kanengomibako/NusoraPlus/README.md

# Nusora+
### Nutube OverDrive Pedal
KORG社の真空管Nutubeを搭載した、真空管らしいスタンダードな歪みが得られるオーバードライブです。

### 各部の機能
- INPUT 端子：ギターや他の機器からの出力を接続します。

- OUTPUT 端子：アンプや他の機器の入力へ接続します。

- +9VDC 端子：ACアダプターを接続します。

  ACアダプターは、DC9V（センターマイナス）出力で、0.1A以上の電流出力が可能なものを使用してください。

- フットスイッチ：エフェクトオン／オフを切り替えます。

- Vol：出力音量を調節します。

- Gain：歪み具合を調節します。

- Tone：音色を調節します。時計回りに回すと、低音域をカットし高音域がブーストされます。

- Comp：ピッキング時の歪みの質感が変化します。繊細なコントロールなため、変化を感じにくい場合があります。

**※ GainとCompは連動しているため、Gainを上げた際はCompは最小付近で変化します。また、Compを上げた際に低音域が増強される現象が起きることがありますが、正常動作となります。**

### 資料
- [Nusora+ 製作に関する記事](https://kanengomibako.github.io/pages/00314.html)

- [Nusora 製作に関する記事](https://kanengomibako.github.io/pages/00304.html)

| 主な仕様 |  |
| - | - |
| 入力インピーダンス | 690kΩ |
| 出力インピーダンス | 1 kΩ |
| バイパス | トゥルー・バイパス |
| コントロール | バイパススイッチ　Volつまみ　Gainつまみ　Toneつまみ　Compつまみ |
| インジケーター | 橙色LED（直径3mm） |
| 接続端子 | INPUT端子　OUTPUT端子　電源入力端子 |
| 消費電流 | 40 mA |
| 外形寸法 | 幅 66 mm × 奥行 100 mm × 高さ 51 mm<br/>（つまみ、スイッチ部を除いた高さ 31 mm） |
| 質量 | 約182 g |
