kanengomibako/NusoraPlus/Nusora_plus_schematic.png

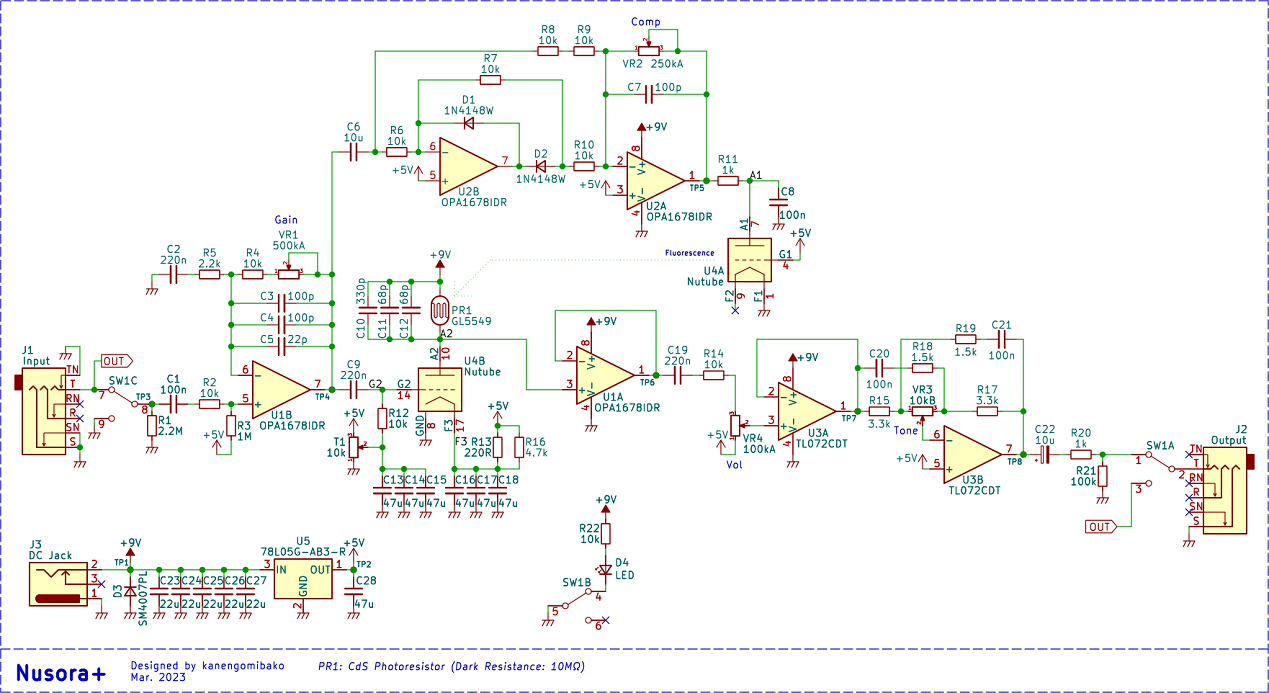
Nusora_plus_schematic.png
