kanengomibako/NusoraPlus/KiCad7/Main/nusora+.kicad_sch

## KiCad design KiCad7/Main/nusora+.kicad_sch (2023-03-23)

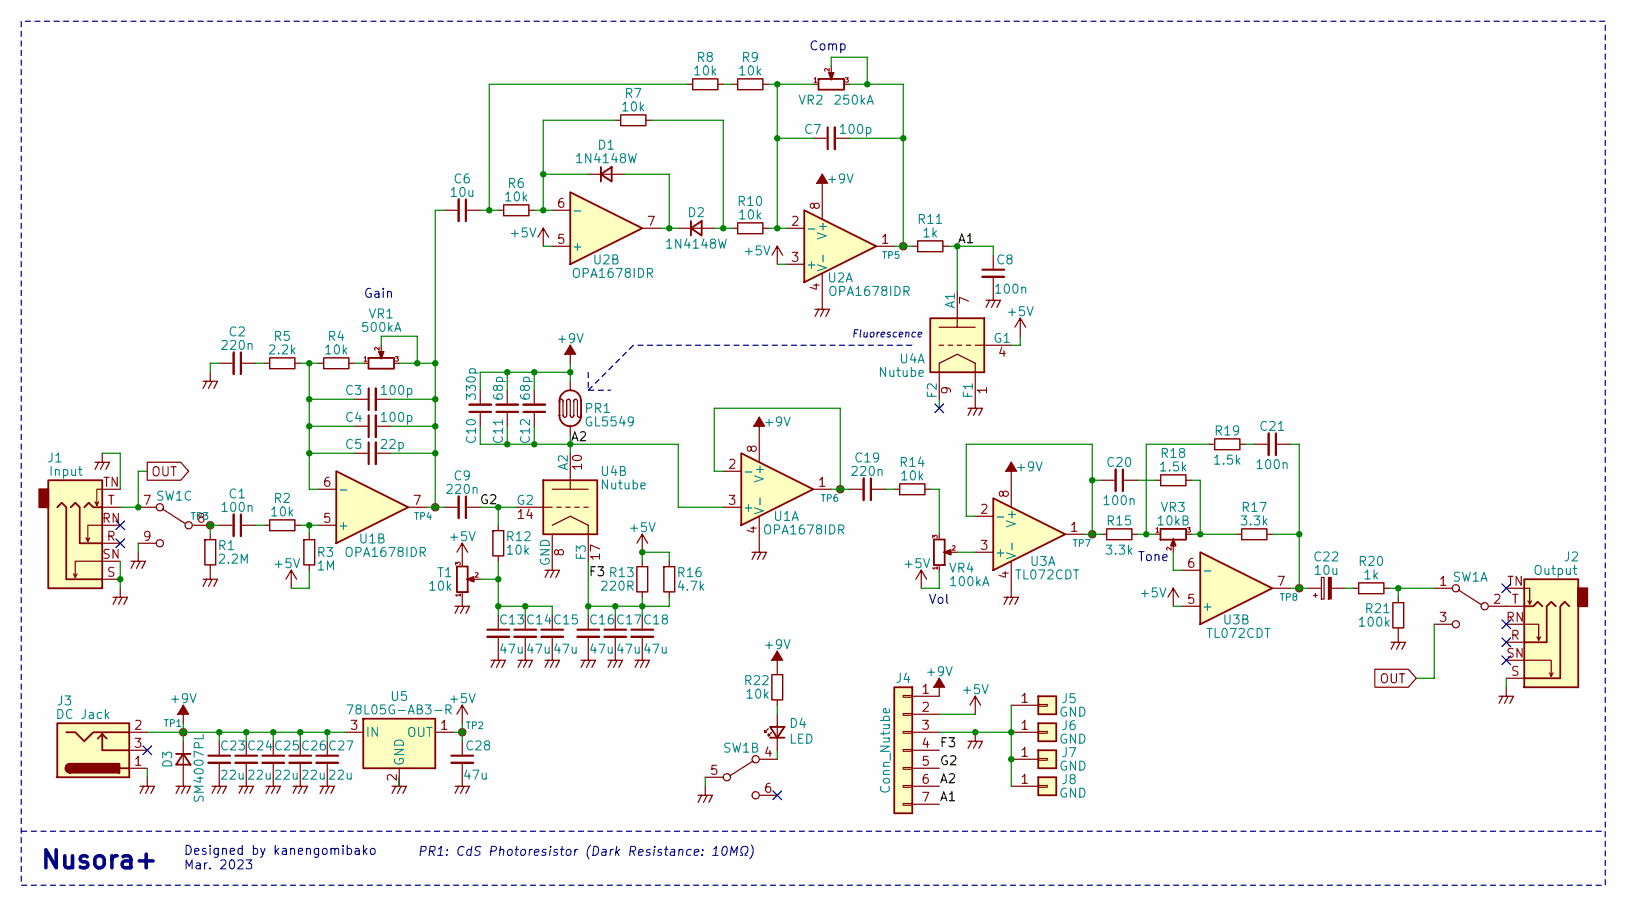
[picture p2: schematic nusora+.kicad_sch]

Parts:
C1, C8, C20, C21: 100n; C_1206_3216Metric
C2, C9, C19: 220n; C_1206_3216Metric
C3, C4, C7: 100p; C_0603_1608Metric
C5: 22p; C_0603_1608Metric
C6: 10u; C_1206_3216Metric
C10: 330p; C_0603_1608Metric
C11, C12: 68p; C_0603_1608Metric
C13, C14, C15, C16, C17, C18, C28: 47u; C_1206_3216Metric
C22: 10u; CP_EIA-3216-18_Kemet-A
C23, C24, C25, C26, C27: 22u; C_0805_2012Metric
D1, D2: 1N4148W; D_SOD-123
D3: SM4007PL; D_SOD-123F
D4: LED; my_LED_3mm
J1: Input; my_Phone_Jack_Daier
J2: Output; my_Phone_Jack_Daier
J3: DC Jack; my_DC_Jack
J4: Conn_Nutube; PinHeader_1x07_P2.54mm_Vertical
J5, J6, J7, J8: GND; PinHeader_1x01_P2.54mm_Vertical
PR1: GL5549; my_C_NP_P2.50mm
R1: 2.2M; R_0603_1608Metric
R2, R4, R6, R7, R8, R9, R10, R12, R14, R22: 10k; R_0603_1608Metric
R3: 1M; R_0603_1608Metric
R5: 2.2k; R_0603_1608Metric
R11, R20: 1k; R_0805_2012Metric
R13: 220R; R_0805_2012Metric
R15, R17: 3.3k; R_0603_1608Metric
R16: 4.7k; R_0603_1608Metric
R18, R19: 1.5k; R_0603_1608Metric
R21: 100k; R_0603_1608Metric
SW1: SW_3PDT; my_sw_3pdt_fujisoku
T1: 10k; my_trim2
TP1: +9V; my_SmallestPad_0-6mmDrill
TP2: +5V; my_SmallestPad_0-6mmDrill
TP3: FX_IN; my_SmallestPad_0-6mmDrill
TP4: U1B_OUT; my_SmallestPad_0-6mmDrill
TP5: U2B_OUT; my_SmallestPad_0-6mmDrill
TP6: U1A_OUT; my_SmallestPad_0-6mmDrill
TP7: U3A_OUT; my_SmallestPad_0-6mmDrill
TP8: U3B_OUT; my_SmallestPad_0-6mmDrill
U1, U2: OPA1678IDR; SOIC-8_3.9x4.9mm_P1.27mm_rotate
U3: TL072CDT; SOIC-8_3.9x4.9mm_P1.27mm_rotate
U4: Nutube; Nutube_small
U5: 78L05G-AB3-R; SOT-89-3-rotate
VR1: 500kA; my_pot123
VR2: 250kA; my_pot123
VR3: 10kB; my_pot123
VR4: 100kA; my_pot123

Connections:
+5V: C28.1, J4.2, R3.2, R13.1, R16.1, T1.3, TP2.1, U2.3 (+), U2.5 (+), U3.5 (+), U4.4 (G1), U5.1 (OUT), VR4.1
+9V: C10.2, C11.2, C12.2, C23.1, C24.1, C25.1, C26.1, C27.1, D3.1 (K), J3.2, J4.1, PR1.2, R22.1, TP1.1, U1.8 (V+), U2.8 (V+), U3.8 (V+), U5.3 (IN)
A1: C8.1, J4.7, R11.2, U4.7 (A1)
A2: C10.1, C11.1, C12.1, J4.6, PR1.1, U1.3 (+), U4.10 (A2)
F3: C16.1, C17.1, C18.1, J4.4, R13.2, R16.2, U4.17 (F3)
G2: C9.1, J4.5, R12.1, U4.14 (G2)
GND: C2.2, C8.2, C13.2, C14.2, C15.2, C16.2, C17.2, C18.2, C23.2, C24.2, C25.2, C26.2, C27.2, C28.2, D3.2 (A), J1.S, J1.SN, J1.TN, J2.S, J3.1, J4.3, J5.1, J6.1, J7.1, J8.1, R1.2, R21.2, SW1.5 (B), SW1.9 (C), T1.1, U1.4 (V-), U2.4 (V-), U3.4 (V-), U4.1 (F1), U4.8 (GND), U5.2 (GND)
unnamed: C1.1, R2.1
unnamed: C1.2, R1.1, SW1.8 (B), TP3.1
unnamed: C2.1, R5.1
unnamed: C3.1, C4.1, C5.1, R4.1, R5.2, U1.6 (-)
unnamed: C3.2, C4.2, C5.2, C6.2, C9.2, TP4.1, U1.7, VR1.2, VR1.3
unnamed: C6.1, R6.1, R8.1
unnamed: C7.1, R9.2, R10.2, U2.2 (-), VR2.1
unnamed: C7.2, R11.1, TP5.1, U2.1, VR2.2, VR2.3
unnamed: C13.1, C14.1, C15.1, R12.2, T1.2
unnamed: C19.1, R14.1
unnamed: C19.2, TP6.1, U1.1, U1.2 (-)
unnamed: C20.1, R18.1
unnamed: C20.2, R15.1, TP7.1, U3.1, U3.2 (-)
unnamed: C21.1, C22.1, R17.2, TP8.1, U3.7
unnamed: C21.2, R19.2
unnamed: C22.2, R20.1
unnamed: D1.1 (K), R6.2, R7.1, U2.6 (-)
unnamed: D1.2 (A), D2.1 (K), U2.7
unnamed: D2.2 (A), R7.2, R10.1
unnamed: D4.1 (K), SW1.4 (A)
unnamed: D4.2 (A), R22.2
unnamed: J2.T, SW1.2 (B)
unnamed: R2.2, R3.1, U1.5 (+)
unnamed: R4.2, VR1.1
unnamed: R8.2, R9.1
unnamed: R14.2, VR4.3
unnamed: R15.2, R19.1, VR3.1
unnamed: R17.1, R18.2, VR3.3
unnamed: R20.2, R21.1, SW1.1 (A)
unnamed: U3.3 (+), VR4.2
unnamed: U3.6 (-), VR3.2
OUT: J1.T, SW1.3 (C), SW1.7 (A)

Notes on the sheet:
_{Fluorescence}
Vol
Nusora+
Gain
Designed by kanengomibako Mar. 2023
PR1: CdS Photoresistor (Dark Resistance: 10MΩ)
Comp
Tone
